alevaquero/esp32-foosball/(list of files, cad)

Other CAD files:
foosbal_scoreboard.blend
foosball_light_support.blend
